georgikeranchev-del/nfc-player/PINOUT.md

# Pinout and Connection Overview

This is the single GPIO connection table for the current battery-only build.
GPIO numbers are ESP32 signal names, NOT physical header positions; clone-board
layouts vary. Classic ESP32/WROOM without PSRAM remains the working assumption,
not a verified module identity. GPIO16 must be available, not used by PSRAM.
GPIO17 is now unused; remove the previous IP5306 KEY-driver connection.
GPIO17 is the only free output-capable pin; GPIO36 is the other free input-only pin.

The symbol, GPIO and component columns are checked against
[firmware/nfc_player/pins.h](firmware/nfc_player/pins.h) and
[hardware.json](hardware.json). Update all three when deliberately changing the
pin map. Connection notes and the diagram are not an electrically checked netlist.
Component IDs correspond to [BOM.csv](BOM.csv).

<!-- PINOUT:BEGIN -->
| Symbol | GPIO | Component | Wire color | Connection and conditions |
|---|---|---|---|---|
| AMP_ENABLE | 2 | U_BUFFER | Green | SN74AHCT125N 2A, pin 5, with 10k to GND; 2Y, pin 6, goes to amplifier SD/SD_MODE. Never connect GPIO2 directly to amplifier SD. Boot-strap review required. |
| ENCODER_SW | 4 | ENC1 | Green | Encoder push switch to GND; active LOW. Wakes normal powered sleep (retaining soft song inhibition), not hard low-battery sleep or a switched-off supply. |
| PN532_SS | 5 | U_NFC | White | PN532 SS/SSEL; set the module to SPI. Verify reset-state module pulls on this boot-strap pin. |
| SD_CS | 13 | U_SD | White | SD module CS. |
| SD_SCK | 14 | U_SD | Blue | SD module SCK/CLK. |
| SD_MOSI | 15 | U_SD | Yellow | SD module MOSI/DI. Verify reset-state pulls on this boot-strap pin. |
| SD_MISO | 16 | U_SD | Brown | SD module MISO/DO; GPIO16 must not be occupied by PSRAM. |
| PN532_SCK | 18 | U_NFC | Blue | PN532 SCK. |
| PN532_MISO | 19 | U_NFC | Brown | PN532 MISO. |
| LED_DATA | 21 | U_BUFFER | White | SN74AHCT125N 1A, pin 2, with 10k to GND; 1Y, pin 3, through 330 ohm to ring DIN. |
| I2S_DOUT | 22 | U_AMP | Pink | MAX98357A DIN. |
| PN532_MOSI | 23 | U_NFC | Yellow | PN532 MOSI. |
| I2S_LRC | 25 | U_AMP | Pink | MAX98357A LRC/WS. |
| I2S_BCLK | 26 | U_AMP | Blue | MAX98357A BCLK. |
| MOTOR_GATE | 27 | U_GATE | Green | TC4420CPA INPUT pin 2 with 10k to GND; joined OUTPUT pins 6/7 through one 100 ohm resistor to IRLZ44N gate. Keep 10k directly between gate and source. GPIO27 does not drive the MOSFET gate directly. |
| ENCODER_CLK | 32 | ENC1 | Green | Encoder A/CLK; common to GND. |
| ENCODER_DT | 33 | ENC1 | Green | Encoder B/DT; common to GND. |
| BATTERY_ADC | 34 | R_BAT_TOP | Green | ADC1_CH6; 100k from SW_BAT+ to ADC node; 47k and 100nF from node to LOAD_GND. Input only; no internal pull resistors. About 1.343V at a 4.20V pack. |
| CHARGER_PRESENT | 35 | Q_VBUS | Green | 2N7000 drain with 100k pull-up to ESP32 3V3 only; LOW means IP5306 USB VBUS is present. Gate: VBUS through 10k, 100k gate-to-GND; source to LOAD_GND. Take VBUS from the IP5306 USB input, not OUT+. Input only, RTC wake capable, no internal pull. Never connect VBUS directly to a GPIO. |
| HELP_BUTTON | 39 | SW_HELP | Green | Existing momentary NO button between GPIO39 and LOAD_GND, with an external 10k pull-up to ESP32 3V3; LOW means pressed. Input only, no internal pull. A short press while idle plays /player/help.mp3. Disconnect the button from IP5306 KEY, which can sit above 3.3 V. |
<!-- PINOUT:END -->

## Signal wire color key

Use red for positive supply/VCC (including 5V) and black for GND/negative.
Use the same color for the same signal role at each component: white for CS/SS
and LED data, blue for clocks (SPI SCK and I2S BCLK), brown for MISO, yellow for
MOSI, green for control/encoder lines, and pink for I2S data and sync. For
example, both SD_MISO and PN532_MISO use brown, and both MOSI lines use yellow.
Matching color does not mean separate GPIO nets are electrically joined; follow
each symbol and GPIO in the table. Keep battery protection terminals distinct;
black denotes the negative node shown, not permission to bypass the PCM.

All ESP32-side logic is **3.3 V, not 5 V tolerant**. GPIO12 and flash GPIO6-11 are
forbidden in this design. The retained straps 2, 5 and 15 are reviewed in
[DESIGN_DECISIONS.md](DESIGN_DECISIONS.md#boot-pin-review).

## Small connection schematic

Open the full-page [SCHEMATIC.svg](SCHEMATIC.svg) for the complete module-level
view, including power protection, TPS61088, the original driver/buffer, battery ADC
and the confirmed 4 ohm / 3 W mono speaker. Named supply nets join across panels.
It is a drawing aid, not proof of clone-board internals or an ERC-checked netlist.

Battery-only whole-system wiring reference

```text
2 x VTC5A in parallel (1S2P) + fuse + 1S PCM
  PCM P+ --+------------------> IP5306 BAT+ (charger only; OUT unused)
           +-- SW_LOAD --> SW_BAT+ --> TPS61088 IN+
  PCM P- ---------------------> IP5306 BAT-, TPS61088 IN-/OUT-, LOAD_GND
  TPS61088 OUT+ (5.00 V) ------> LOAD_5V
  SW_BAT+ -- 100k --+----------> GPIO34 / ADC1_CH6
                   +-- 47k ---> LOAD_GND
                   +-- 100nF -> LOAD_GND

LOAD_5V --+--> ESP32 VIN/5V
          +--> amplifier VIN, ring 5V, AHCT125 VCC, TC4420 VDD
          +--> motor +
motor - ------> IRLZ44N drain; source --> LOAD_GND
flyback diode: anode --> motor -; band/cathode --> motor +

GPIO27 --> TC4420 pin 2; joined pins 6/7 --> 100 ohm --> IRLZ44N gate
GPIO21 --> AHCT125 channel 1 --> 330 ohm --> ring DIN
GPIO2  --> AHCT125 channel 2 -------------> amplifier SD
GPIO4  --> encoder push switch --> LOAD_GND

LOAD_GND --> module grounds, buffer/driver grounds, divider return
ESP32 3V3 --> encoder breakout VCC, only if it needs power
```

- SD and PN532 supply voltages depend on the actual breakout schematic; they are
  deliberately absent from the blanket 5 V list. Their SPI signals must be 3.3 V
  compatible. Do not drive any unpowered module through its GPIO connections.
- SN74AHCT125N DIP-14: join pins 1, 4, 7, 9, 12 to LOAD_GND; join pins 10, 13, 14
  to LOAD_5V. Outputs 8 and 11 each stay open. Never join separate outputs 3, 6,
  8 or 11 together. Inputs 2 and 5 keep separate 10k pulldowns, not direct ground
  bridges. Add 100 nF between pins 14/7. Use AHCT, not plain HC.
- TC4420CPA DIP-8: join VDD pins 1/8 to LOAD_5V; join GND pins 4/5 to LOAD_GND;
  join OUTPUT pins 6/7 before the single 100 ohm gate resistor. INPUT is pin 2;
  pin 3 is NC and stays open. All three duplicate pairs must be connected
  externally. Add 100 nF plus 1 uF local bypass across the VDD/GND groups. Gate,
  driver-input and buffer-input pulldowns remain required; this text overview
  omits their drawn symbols.
- Amplifier SD must not be hard-strapped to VIN. GAIN is separate; both speaker
  wires go to amplifier outputs, neither to ground. See the breakout checks in
  [WIRING.md](WIRING.md#dip-ahct125-led-and-amplifier).
- The load switch must remove power from BOTH the boost input and divider top.
  Do not leave a battery-powered divider driving an unpowered ESP32. Keep the
  ADC return on protected P-/LOAD_GND, never raw B-. See the
  [divider and calibration](WIRING.md#battery-voltage-divider) instructions.

DIP numbering is top view, notch at the top and pin 1 upper-left; the solder-side
view is mirrored. Use short socket-pad links or a common local rail for each
group, keeping different groups separate. See the complete
[pin-bridge tables](WIRING.md#tc4420cpa-dip-8-pin-bridges) before soldering.

The diagram is an overview, not a replacement for protection terminals, capacitor
placement and reset-state checks in [WIRING.md](WIRING.md). All load returns must
remain on the protected side of the battery circuit.

## Manufacturer reference diagrams

These are the closest useful block references, not a verified schematic of the
complete K648/DevKit/breakout combination. Use this project's GPIO assignments;
other boards' example GPIO numbers and power wiring are not interchangeable.

- [Microchip TC4420/29 datasheet, page 1](https://ww1.microchip.com/downloads/aemDocuments/documents/APID/ProductDocuments/DataSheets/21419D.pdf#page=1):
  TC4420 non-inverting DIP-8 pin diagram and the requirement to connect both pins
  of every duplicate supply/GND/output pair; pin 3 is NC.
- [TI SN74AHCT125 datasheet, page 3](https://www.ti.com/lit/ds/symlink/sn74ahct125.pdf#page=3):
  DIP-14 pin diagram; later sections cover active-LOW enables, bypass/layout and
  TTL input levels.
- [Adafruit MAX98357A mono schematic](https://cdn-learn.adafruit.com/assets/assets/000/032/642/medium800/adafruit_products_schem.png?1464034817):
  close reference for the seven-pin I2S amplifier. Compare SD/GAIN resistors and
  supply capacitors with the actual breakout; do not assume a clone matches it.
  [Downloads and board files](https://learn.adafruit.com/adafruit-max98357-i2s-class-d-mono-amp/downloads).
- [Adafruit NeoPixel wiring practices](https://learn.adafruit.com/adafruit-neopixel-uberguide/best-practices):
  data resistor, local capacitance, common ground and 3.3 V to 5 V level shifting.

The exact K648 power path, DevKit USB/VIN routing and SD/PN532 supply circuitry
still require their board schematics or inspection. They are not inferred from
the silicon names. The dedicated shunt connection diagram and scope settings are
in [MANUAL_TESTS.md](MANUAL_TESTS.md#inrush-current-with-a-shunt-and-oscilloscope).

## USB programming boundary

No tag is NOT power isolation. For the current programming procedure, disconnect
the complete player harness, including GPIOs, from ESP32 and use its USB alone.
Remove USB before reconnecting battery wiring. A powered ESP32 can back-feed
unpowered peripherals even with the motor stopped. Simultaneous charging and
fully wired dual-USB operation have separate gates in
[MANUAL_TESTS.md](MANUAL_TESTS.md#later-usb-and-charging-tests).
