georgikeranchev-del/nfc-player/MODELS.md

# 3D Model References

This page lists external mechanical references considered during development of
the NFC Vinyl Player. **This repository branch contains no 3D model files.**
The links below point to third-party pages; they are references, not included
assets, verified downloads, or confirmation that a model is used in the build.

The current mechanical concept uses an N20 geared motor, a spindle/drive
interface, a turntable, and an enclosure for the ESP32/NFC/audio electronics.
Compatibility with the actual parts has not been established for the linked
models.

## Proposed enclosure layout

The [conceptual enclosure layout](ENCLOSURE_LAYOUT.svg) places the PN532 antenna
under the platter center, keeps the battery and motor away from the antenna, and
puts the K648 charging and DevKit programming USB connectors on the same side
wall for access. It is a top-down placement suggestion, not a dimensioned model
or validated mechanical/electrical design. Verify clearances, antenna read range,
connector fit, and the USB power-isolation procedure with the actual parts before
making enclosure cutouts.

## Drive and pulleys

| Reference | Potential use | Source |
|---|---|---|
| [5mm Pulley with D-Shaft for 1/2" Spindle](https://makerworld.com/en/models/1469934-5mm-pulley-with-d-shaft-for-1-2-spindle?from=search#profileId-1534154) | Candidate pulley / spindle interface | MakerWorld |
| [N20 Motor Horn 3mm D-Shaft Flange Coupler](https://makerworld.com/en/models/1723479-n20-motor-horn-3mm-d-shaft-flange-coupler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) | Candidate motor-shaft coupling | MakerWorld |
| [polea n20](https://cults3d.com/en/3d-model/various/polea-n20) | N20 pulley reference | Cults3D |
| Worm-gear model | Drive mechanism reference | Source not recorded |

## Motor mounting and adapters

| Reference | Potential use | Source |
|---|---|---|
| [N20 Motor Bracket](https://www.printables.com/model/669433-n20-motor-bracket/related) | General N20 motor mounting | Printables |
| [N20 DC Motor Holder](https://makerworld.com/en/models/1734552-n20-dc-motor-holder#profileId-1842737) | Compact motor holder | MakerWorld |
| [N20 Reduction Gear Motor Mount](https://makerworld.com/en/models/595578-n20-geared-motor-mount?from=search#profileId-517501) | Geared-motor mounting | MakerWorld |
| [N20 Geared Motor Fixing](https://makerworld.com/en/models/1778632-n20-geared-motor-fixing?from=search#profileId-1894420) | Alternative motor mounting | MakerWorld |
| [Faller Motor Adapter N20 Geared Motor](https://makerworld.com/en/models/1907006-faller-motor-adapter-n20-geared-motor?from=search#profileId-2044507) | Motor adapter reference | MakerWorld |
| N20 bracket design files | Alternative motor bracket reference | Source page not recorded |

## Turntable and enclosure

| Reference | Potential use | Source |
|---|---|---|
| [Lazy Susan Turntable for Photo/Painting with Bearing](https://makerworld.com/en/models/1526805-lazy-susan-turntable-for-photo-painting-w-bearing#profileId-1600602) | Bearing-based turntable concept | MakerWorld |
| [Turntable — 8 cm Diameter (608 Bearing)](https://makerworld.com/en/models/756683-turntable-8cm-diameter-608-bearing#profileId-691020) | Compact platter and bearing concept | MakerWorld |
| [Digital Vinyl Record Player (NFC enabled) — V1](https://makerworld.com/en/models/140367-digital-vinyl-record-player-nfc-enabled-v1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) | Related NFC record-player concept | MakerWorld |
| [Parametric Model Maker — Universal PCB Enclosure](https://makerworld.com/en/models/2487622-universal-pcb-enclosure-fully-parametric#profileId-2733152) | Configurable electronics enclosure | MakerWorld |
| [Parametric Rounded Electronics Enclosure Box](https://www.printables.com/model/1745945-parametric-rounded-electronics-enclosure-box-usb-c/files) | Enclosure geometry reference | Printables |
| [JUUKE — RFID Music Player](https://www.printables.com/model/54266-juuke-rfid-music-player) | Related RFID player reference | Printables |

## Rights and suitability

This list does not state or imply that a linked model is free to download,
modify, or redistribute. Check the current terms on the source page for each
model before downloading, adapting, sharing, or publishing model files. A
personal-use allowance or free download does not necessarily permit public
redistribution.

Before adapting any model, verify motor dimensions, shaft geometry, bearing
dimensions, platter size, mounting holes, enclosure clearances, and fit with
the actual electronics and mechanical parts. These links are starting points,
not approved drop-in parts or a validated mechanical design.
