georgikeranchev-del/nfc-player/NFC_TAGS.md

# NFC Tags

Use each UID as the MP3 filename in the SD card's `/player` folder, followed by
`.mp3` (for example, `047D5D91E52A81.mp3`). An em dash means the tag has not
been assigned a song yet.

| Tag | UID | Artist | Track |
|---:|---|---|---|
| 1 | `047D5D91E52A81` | Mariah Carey | All I Want for Christmas Is You |
| 2 | `04955D91E52A81` | Wham! | Last Christmas |
| 3 | `04925D91E52A81` | Ariana Grande | Santa Tell Me |
| 4 | `04EA6391E52A81` | Bobby Helms | Jingle Bell Rock |
| 5 | `04E86391E52A81` | Andy Williams | It's the Most Wonderful Time of the Year |
| 6 | `04F16391E52A81` | Dean Martin | Let It Snow! Let It Snow! Let It Snow! |
| 7 | `04F26391E52A81` | Тодор Върбанов | Миг като вечност |
| 8 | `04E76391E52A81` | — | — |
| 9 | `04EB6391E52A81` | — | — |
| 10 | `04915D91E52A81` | — | — |
| 11 | `04965D91E52A81` | — | — |
| 12 | `047C5D91E52A81` | — | — |
| 13 | `04845D91E52A81` | — | — |
| 14 | `04235891E52A81` | — | — |
| 15 | `04245891E52A81` | — | — |
| 16 | `04EB5791E52A81` | — | — |
| 17 | `04F15791E52A81` | — | — |
| 18 | `04845291E52A81` | — | — |
| 19 | `04895291E52A81` | — | — |
| 20 | `045C5291E52A81` | — | — |
| 21 | `04645291E52A81` | — | — |
| 22 | `04E24B91E52A81` | — | — |
| 23 | `04E34B91E52A81` | — | — |
| 24 | `04A84B91E52A81` | — | — |
| 25 | `04AD4B91E52A81` | — | — |
| 26 | `042F4691E52A81` | — | — |
| 27 | `04354691E52A81` | — | — |
| 28 | `04E84591E52A81` | — | — |
| 29 | `04EF4591E52A81` | — | — |
| 30 | `046C3F91E52A81` | — | — |
| 31 | `046D3F91E52A81` | — | — |
| 32 | `04283F91E52A81` | — | — |
| 33 | `042F3F91E52A81` | — | — |
| 34 | `048F3991E52A81` | — | — |
| 35 | `04953991E52A81` | — | — |
| 36 | `04483991E52A81` | — | — |
| 37 | `044B3991E52A81` | — | — |
| 38 | `04AF3391E52A81` | — | — |
| 39 | `04B33391E52A81` | — | — |
| 40 | `04643391E52A81` | — | — |
| 41 | `04693391E52A81` | — | — |
| 42 | `047E2E91E52A81` | — | — |
| 43 | `04862E91E52A81` | — | — |
| 44 | `04392E91E52A81` | — | — |
| 45 | `043E2E91E52A81` | — | — |
| 46 | `04192991E52A81` | — | — |
| 47 | `041E2991E52A81` | — | — |
| 48 | `04A6B591E52A81` | — | — |
| 49 | `04B72891E52A81` | — | — |
| 50 | `04192391E52A81` | — | — |
