georgikeranchev-del/nfc-player/WIRING.md

# Battery-Only Perfboard Wiring

This is the new baseline, superseding contradictory advice in the old chat and
parent wiring file. Keep the existing classic ESP32 development board, IP5306/K648,
PN532, SD module, MAX98357A, ring, N20 motor and encoder. Reuse their existing
capacitors if identified and undamaged. The selected load supply is now a
**TPS61088 JXL V1.10 module set to 5.00 V**, replacing the XL6009. IP5306 is used
only for charging; its OUT pins do not feed the player. The battery is two matched
VTC5A cells in parallel (1S2P), with suitable 1S protection and a coordinated fuse.

Reported silicon is **ESP32-D0WD-V3, revision v3.1, with a 40 MHz crystal**.
This does not confirm the development-board/module model or PSRAM. WROOM without
PSRAM is the working assumption from the reported earlier check, not a verified
module identity. Use [PINOUT.md](PINOUT.md) for the complete GPIO table, GPIO16
restrictions and compact connection schematic. Full reported chip details are in
[README.md](README.md#detected-esp32).

## Signal wire colors

Use red for positive supply/VCC (including 5V) and black for GND/negative.
Color signal wires by role consistently across components: white for CS/SS and
LED data, blue for clocks (SPI SCK and I2S BCLK), brown for MISO, yellow for
MOSI, green for control/encoder lines, and pink for I2S data and sync. Therefore
SD and PN532 MISO use the same brown wire, and both MOSI lines use yellow. Same
color does not mean different GPIO nets are connected together; keep each routed
to its pin as shown in [PINOUT.md](PINOUT.md) and [SCHEMATIC.svg](SCHEMATIC.svg).
Keep raw cell terminals on the correct sides of the PCM; black does not authorize
bypassing battery protection or joining raw B- to system GND.

## What to buy

- **1 x SN74AHCT125N, DIP-14, plus socket:** LED level shift and amp SD isolation.
- **1 x TC4420CPA, DIP-8, plus socket:** non-inverting 5 V motor gate driver for
  the IRLZ44N you own; check the exact suffix is PDIP, not SMD/inverting TC4429.
- **1 x 1N5822 axial Schottky:** motor flyback baseline. A 1N5819 is an alternative
  only if its 1 A/transient ratings fit your measured motor. No 1N4007 for PWM.
- **100 nF X7R ceramics, >=16 V:** buy a small pack for each logic/driver supply;
  one 1 uF ceramic at the gate driver. Yellow box film caps can remain for motor
  brush suppression once their value/rating is confirmed.
- **Resistors:** keep motor 100 ohm and gate/source 10k, LED data 330 ohm. Add
  10k pulldowns at gate-driver input, amp-buffer input and LED-buffer input.
- **Battery divider:** one 100k and one 47k, both 1% metal-film, 0.25 W;
  one additional 100 nF X7R ceramic, >=16 V, at GPIO34. No KEY transistor is needed.
- **TPS61088 JXL V1.10 boost module:** verify the actual board's input range,
  output adjustment, current/thermal limits and undervoltage behavior before use.
- **Cell protection and fuse hardware:** documented protected 1S cell or compatible
  1S PCM, DC-rated fuse holder, rated battery holder/leads/connectors and heatshrink.
  Final fuse/PCM current is a measurement decision, not a generic 3 A shopping rule.
- **Perfboard, sockets/header strips, rated connectors, insulated wire, standoffs**
  and a DC-rated SPST load switch if you want physical off. Use mounting support
  for the encoder; do not support the box/knob by solder joints alone.
- Keep the existing encoder. Its push switch wakes normal powered sleep;
  cold-start uses the load switch, not IP5306 KEY.

Exact inventory and quantities are in [BOM.csv](BOM.csv). A gate driver and logic
buffer do not solve boost overload, poor wiring, inappropriate battery selection,
or a mechanically stalled platter.

## Perfboard connectors, wire and sockets

The selected ICs remain **TC4420CPA** and **SN74AHCT125N**. The previously discussed
TC4427/74HCT126 alternatives are not adopted; do not mix their pinouts or enable
wiring with this build.

Soldering module power leads directly to their labelled supply/GND pads is fine.
Terminate the other ends at rated, labelled terminal blocks on the perfboard so
modules remain removable. Secure the cable independently of the solder pad and
insulate exposed joints. Do not hang stiff wire or a heavy capacitor from a small
breakout pad. This advice is for module pads, not soldering directly to a cell.

| Proposed copper cross-section | Use and conditions |
|---|---|
| 1.5 mm2 | Ample starting point for short main power/return buses at the expected few-amp scale. It may be too stiff or large for perfboard holes; use supported distribution terminals or an insulated bus, not enlarged pads or a chain of solder blobs. |
| 0.5 mm2 | Reasonable for short individual motor, amplifier and LED power/return branches. Verify voltage drop and temperature at measured current, plus the terminal/connector rating and fuse coordination. |
| 0.33 mm2 | Electrically ample for GPIO signals; often larger than necessary. For SPI/I2S/LED data, short routing and nearby return paths matter more than copper area. |

These are conditional wiring choices, not certified current ratings. Battery-side
current can exceed 5 V load current. Include both outgoing and return conductors
when calculating voltage drop; connector contacts and thin module traces may
limit the circuit before the wire does. Keep motor/amp/ring returns separate back
to the distribution point, not through ESP32 headers or a signal-ground jumper.

Use terminal blocks specified for the conductor size and measured current. For
stranded wire under screw clamps, use suitable ferrules where the terminal maker
permits them; do not tin the clamped ends because solder can creep and loosen.
Use proper crimps/torque and provide strain relief. Soldered ends at PCB pads are
a different case and should be wetted normally. Label 5 V, 3V3, GND and signals;
different module supply voltages are not interchangeable.

Keep SPI and I2S wiring as short as practical, initially around 10 cm or less
where layout permits; this is a layout goal, not a guaranteed maximum. Route
clock/data with a nearby ground return and away from motor/gate/speaker wiring.
Route each motor or supply outgoing/return pair together. Twist the two speaker
leads together; neither speaker lead is a ground return.

Good-quality DIP-8 and DIP-14 IC sockets on perfboard are appropriate. Align the
socket notch and IC pin 1, inspect solder joints before inserting ICs, and insert
or remove only with all power disconnected. Keep the gate resistor, pulldowns
and driver bypass close to their relevant pins, not at the far end of a cable.

Headers/sockets also make the DevKit removable. If the DevKit is permanently
soldered, provide disconnectable connections for its complete player harness,
including supply and GPIO paths. The present USB programming procedure requires
that isolation; disconnecting only VIN while leaving GPIOs connected is not enough.

## Battery, protection and main switch

```text
1S2P VTC5A pack + -- F1 (near pack +) -- PCM B+
1S2P VTC5A pack - -------------------- PCM B-
PCM P+ --+---------------------------- IP5306 BAT+ (charger only)
         +-- SW_LOAD -- SW_BAT+ --+---- TPS61088 IN+
                                +---- battery divider top (100k)
PCM P- ------------------------------ IP5306 BAT-, TPS61088 IN-/OUT-, LOAD_GND

TPS61088 OUT+ (set to 5.00 V) --------- LOAD_5V star
IP5306 OUT+ and OUT-: no external load connection

LOAD_5V -> ESP32 VIN/5V, amp VIN, ring 5V, motor +, AHCT125 VCC, TC4420 VDD
LOAD_GND -> all module returns, MOSFET source, driver/buffer GND, divider return
```

Use the PCM manufacturer's real terminals, not inferred positions. A protected
cell already contains its own circuit; select one documented protection solution.
Never bypass low-side PCM protection by connecting load ground to bare cell -.
Size switch, wiring, connector and fuse for BATTERY current as well as load peaks.
Fuse coordination must allow expected transients but protect the weakest wire
and cell limits. Do not intentionally short a lithium cell to test protection.

**Move SW_LOAD from the old 5 V output position to the protected battery branch
feeding BOTH TPS61088 IN+ and the divider.** The IP5306 BAT connection stays
upstream of this switch, so charging remains possible with the player off.
Rate the switch for battery-side current, which can exceed the 5 V load current.
An output-only switch would leave the divider driving an unpowered ESP32.
Disconnect the ADC lead too whenever removing just the ESP32's power.

IP5306 BAT+/BAT- means its cell terminals (sometimes marked IN+/IN-), not its
USB 5 V input. Confirm the TPS61088 module has a common IN-/OUT- return with all
power removed. Keep both USB cables unplugged for battery-only tests. No source
mux, CC1/CC2 detection or converter EN control is implemented.

SW_LOAD open (`0`) leaves the charger connected to the protected pack; closed
(`1`) allows both the player and charger to use that port. With USB connected,
the pack can charge, remain approximately neutral or discharge depending on net
current. This is not a validated load-sharing/charge-termination circuit; test
both charge completion and net cell current with playback. IP5306 OUT is not a
charger-present signal because it can also be battery-powered.

On the schematic, only repeated instances of the SAME net label connect.
PCM P+ and SW_BAT+ are joined only through the closed switch. LOAD_GND is a
separate return net: never join positive to negative just because both are named.

For battery-only development omit the former series rail diode. Route TPS61088
output straight to the star. Do not put motor/amp current
through the ESP32 headers, skinny daisy-chain jumpers or long perfboard solder
tracks. Use short power wires and pair each signal with a nearby return path.

### Battery voltage divider

```text
SW_BAT+ (protected P+ after SW_LOAD, also TPS61088 IN+)
  |
  100k ohm, 1%, 0.25 W    R_BAT_TOP
  |
  +---------------------- GPIO34 / ADC1_CH6 (input only)
  |              |
  47k ohm        100 nF X7R
  1%, 0.25 W     >=16 V
  |              |
  +--------------+------- LOAD_GND (protected return, NEVER raw B-)
```

Fit the 47k and capacitor close to the ESP32. Keep this sense wire away from
motor/speaker/switching nodes and give it a quiet return to the ground star.
GPIO34 has no internal pull resistors; the external 47k is required. Never
connect pack voltage or regulated 5 V directly to it. Verify the divider with
a meter before attaching the ADC lead to the ESP32.

The nominal conversion is `V_ADC = V_input * 47 / 147`: 4.20 V gives about
1.343 V; 3.60 V gives 1.151 V; 3.30 V gives 1.055 V. Divider current is about
29 microamps at 4.20 V. The 100 nF capacitor filters sampling/switching noise.
Firmware uses 12-bit `analogReadMilliVolts`, 6 dB attenuation, 16 readings per
sample and a 250 ms sample interval. The measured value includes protection,
switch and wiring drop; it is the boost-input voltage, not a separate raw-cell
measurement. The ratio is not doubled for two parallel cells.

ADC background, from the ESP-IDF
[ADC](https://docs.espressif.com/projects/esp-idf/en/latest/esp32/api-reference/peripherals/adc/index.html) and
[calibration](https://docs.espressif.com/projects/esp-idf/en/latest/esp32/api-reference/peripherals/adc/adc_calibration.html)
guides: the classic ESP32 ADC reference is nominally 1100 mV but varies between
1000 and 1200 mV per chip, and the calibration driver corrects that using eFuse
values (your chip reports Vref calibration burned). Espressif also recommends a
100 nF ceramic at the ADC pin and multisampling against noise, as used here
(their graph uses 64 samples; this firmware uses 16). The Arduino
`analogReadMilliVolts` call is expected to apply that eFuse calibration, but this
is not yet verified on the actual board. The meter-derived factor below then corrects
what remains: resistor tolerance and residual ADC error. It is one point, so
also check it at a second voltage.

Calibrate `BATTERY_CALIBRATION_PERMILLE` in
[config.h](firmware/nfc_player/config.h) against a meter across SW_BAT+/LOAD_GND,
not against the nominal cell rating or a percentage estimate. The serial log
reports ADC millivolts and corrected pack millivolts at boot and every 5 s while
awake. Follow the [calibration procedure](MANUAL_TESTS.md#battery-voltage-calibration-and-cutoff)
for the correction formula, safe receive-only logging and cutoff tests.

Conservative initial settings are 3.50 V minimum for a new song and soft song
inhibition after 5 s below it. A tag request while inhibited plays
`/player/low_battery.mp3` once at volume 10 with motor/LEDs off; the warning is
limited to 10 s. Normal sleep/wake preserves this latch; rebound alone cannot
clear it. Songs re-enable only with USB present and at least 3.70 V for 30 s
(see [charger-present sense](#charger-present-sense)). A true power
cycle checks startup voltage again. Neither this threshold nor the divider can
establish that exactly 5-10% capacity remains; calibrate voltage with a meter,
then characterize the pack under the real load before choosing an SOC estimate.

Hard shutdown still occurs at startup at/below 3.30 V, after at/below 3.30 V
for 2 s while running, and immediately at/below 3.00 V on a sampled reading.
A reading above 4.35 V also stops operation as a wiring/calibration fault.
These are operating choices, not VTC5A absolute limits. Sampling is cooperative,
not a hard real-time protection circuit.

Hard low-battery shutdown stops motor/audio/NFC polling, clears LEDs and deep-sleeps
without button or timer wake. Open SW_LOAD, recharge, then switch on again;
charging alone does not wake it. **Deep sleep does not disconnect the TPS61088,
SD, PN532 or other rail loads, and the ADC no longer monitors during sleep.**
Do not store it in this state. Keep the PCM as independent protection. A proper
hardware low-voltage disconnect is needed for unattended automatic isolation;
do not assume the JXL board's UVLO or EN provides that without its schematic and
measurements. A heatsink or quieter audio cannot correct over-discharge.

### Charger-present sense

```text
IP5306 USB-C VBUS pad --10k-- +-- 2N7000 gate (G)
                              |
                              100k to LOAD_GND

ESP32 3V3 --100k-- +-- 2N7000 drain (D) -- GPIO35 (input only)
2N7000 source (S) -- LOAD_GND
```

Take VBUS from the IP5306 module's USB input (connector VBUS pin or input pad),
not OUT+, which can also be battery-powered. That module's ground is the protected
P-/LOAD_GND. USB present puts about 4.5 V on the gate and GPIO35 reads LOW. This
only senses USB power: it does not switch any load, and it does not prove the
cell is actually charging. The pull-up goes to ESP32 3V3 only, never 5 V. TO-92
2N7000 pin order varies by maker; check the datasheet or the flat face. GPIO35 is
input only with no internal pull and supports deep-sleep wake; GPIO17 does not.

### Fuse and PCM during startup

**A 3 A marking is not an instantaneous cutoff at 3.001 A.** The BOM still leaves
fuse and protection selection open; no particular 3 A part is approved here.

- An ordinary cartridge/blade fuse is a one-time protective component. A short
  pulse above its rating may survive, while a larger/longer overload can melt it.
  Use the exact fuse's time-current curve, pulse endurance, ambient derating and
  DC breaking rating. Fast-acting and time-delay 3 A fuses need not behave alike.
  If it blows, correct the cause before replacing it with the approved type; do
  not bridge it or simply install a higher rating.
- A resettable PTC is different: it heats into a high-resistance state and may
  recover after the fault is removed and it cools. Hold/trip current, resistance
  and delay differ from a fuse. It is not an automatic drop-in substitute here.
- A PCM normally turns off its protection MOSFETs on a detected fault rather than
  consuming itself. Its advertised continuous rating, overcurrent trip threshold,
  detection delay and permitted surge rating are separate specifications. A
  "3 A" board may trip above 3 A, but that does not authorize sustained overload.
  Recovery may require load removal or a manufacturer-specified charger event;
  never short pads to reset it. A poorly rated, overheated or miswired board can
  still be permanently damaged, including failure to protect.

Coordinate the fuse, PCM, cell and weakest wire/contact with the measured battery
current and surge duration. The motor ramp does not control all cold-start inrush:
charging the capacitors and booting the boost happen before the ramp. If normal
running already exceeds a PCM's continuous rating, a longer ramp cannot fix it.
Repeated trips, hot protection parts or blown fuses are faults to investigate,
not expected startup behavior. Keep the load off until the cause is understood.

### Connecting the 18650 holder and PCM

The diagram above applies to a **documented 1S, 4.20 V Li-ion, common-port PCM**:
the same protected P+/P- port carries discharge and later charge current. It is
not a pin-position guide for an unidentified board. The PCM protects the pack;
IP5306 charges it and TPS61088 supplies the player. A 2S/3S PCM is not suitable.

For the matched parallel pack, the electrical connections are:

```text
Pack + --> F1 close to pack + --> PCM B+
Pack - ------------------------> PCM B-
PCM P+ ------------------------> IP5306 BAT+ and SW_LOAD input
PCM P- ------------------------> IP5306 BAT- and protected system return
```

All player grounds stay on the protected side. Do not connect holder - directly
to ESP32, amplifier, motor-driver or USB ground around the PCM. Some common-port
boards share B+ and P+ copper; others label pads differently. Do not infer pad
positions or add bridges from that generalization. Boards with separate C-/P-
charge/discharge ports require their own wiring plan; the K648 BAT connection
both charges and discharges, so do not join those ports by guesswork.

Remove the cell from the holder and disconnect every USB/external supply before
soldering or continuity work. Mount the PCM on insulated supports or secure it
against an insulating backing; no underside copper may touch perfboard buses,
fasteners or the cell holder. Solder flexible pigtails to its labelled pads and
land them on rated terminals, with strain relief. Do not force stiff 1.5 mm2 wire
onto tiny PCM pads or carry pack current through small perfboard pad chains.
Do not solder directly to the cell. Leave the fuse/cell out until wiring checks
are complete, and follow the board maker's connection/activation sequence.

The holder must fit the actual cell and have documented contacts/leads adequate
for battery current. A holder is not protection. If using an already protected
cell or protected pack, use its documented terminals instead of blindly stacking
a second, uncoordinated PCM. The exact PCM model/pad labels and fuse part number
are needed before treating the wiring and surge tolerance as verified.

### 18650 selection

The selected cells are **two matched VTC5A cells in parallel**, not in series.
"18650" describes size, not chemistry, current capability or protection. The
general checks below still apply to this 1S2P pack and the actual K648 charger.

| Parameter | What to look for |
|---|---|
| Chemistry/voltage | Conventional rechargeable Li-ion, nominal 3.6/3.7 V, charged to 4.20 V. Verify K648 is configured for that cell. LiFePO4 or a different charge-voltage chemistry is not a drop-in substitute. |
| Capacity | Genuine 2500-3500 mAh is a practical shopping range; around 3000 mAh is a useful starting point. Capacity mainly determines runtime, not whether motor startup succeeds. |
| Discharge rating | Prefer a documented continuous discharge rating of at least 10 A as a shopping target with margin; ignore unqualified "pulse/max" marketing. Final suitability depends on measured current, sag and temperature. This is not a 10 A fuse recommendation or an IP5306 output rating. |
| Charge rating | Check the cell's recommended and maximum charge current separately from its discharge rating. The actual K648 cell-charging current must comply; USB input current is not the same measurement. If incompatible, reconfigure only by the module's documented method or select a compatible cell before charging. |
| Protection | Use a documented protected cell/pack OR a suitable external 1S PCM. Its charge/discharge limits, trip thresholds and wiring must suit the cell and measured startup current. A high-current bare cell behind a low-current protection board is still limited by that board. |
| Construction | Buy from a reputable battery supplier with a manufacturer datasheet and traceable model. Reject damaged wraps/positive-terminal insulators, dents and unknown salvaged cells. Avoid implausible capacity claims. |
| Fit/connections | Protected/button-top cells may be longer than a bare 65 mm cell. Check the exact holder dimensions and contact-current rating. Use a rated holder or professionally assembled pack with welded tabs/leads; do not solder directly to the cell. |
| Temperature/voltage limits | Follow the cell datasheet's operating and charging temperatures and minimum voltage. Choose an operating cutoff with sag margin above the minimum/protection trip. Supervise development charging; do not assume the module has cell-temperature sensing. |

A higher-current cell does not force current into the load, but it can deliver
more current into a fault: protection, a correctly coordinated fuse and insulated
connections remain necessary. It cannot increase the TPS61088 module's own output
capability. A healthy existing cell that meets the measured requirements need
not be replaced just to obtain a larger mAh number.

Size the battery path from battery current, not the 5 V current. Approximately:

$$
I_{cell} \approx \frac{V_{load} I_{load}}{V_{cell} \eta}
$$

For example, a 5.1 V load drawing 2 A needs about **3.75 A from a 3.2 V cell** at
an assumed 85% boost efficiency, before allowing for transients. These are sizing
examples, not measured load/efficiency or a recommended discharge endpoint. Check
startup at the lowest intended battery level: the same output power needs more
battery current as voltage falls.

For a first runtime estimate:

$$
t_{hours} \approx \frac{V_{nominal} C_{Ah} \eta}{P_{load,average}}
$$

A 3.6 V, 3000 mAh cell contains nominally 10.8 Wh. At an assumed 85% efficiency,
that gives roughly **1.8 hours at 5.1 V / 1 A average load**, or **0.9 hours at
2 A**. Usable capacity, cutoff, motor/audio peaks, temperature and cell condition
can reduce this. Measure average power with representative music and lighting;
do not treat the full labelled capacity as mAh available at 5 V.

### Selected VTC5A 1S2P pack

The two matched VTC5A cells have the same voltage as one cell: about **3.6 V
nominal and 4.20 V fully charged**, not 7.2/8.4 V. Capacity adds and current is
shared, subject to cell/connection matching. Actual runtime depends on usable capacity, cutoff,
temperature and conversion efficiency. Charging from the same limited current
will take roughly longer in proportion to capacity.

The electrical topology is parallel (positive to positive, negative to negative),
but this is not authorization to connect two loose cells or holders together.
Different cell voltages can cause large equalization current before the player
draws anything. A pack PCM does not necessarily interrupt circulating current
between parallel cells. Matching voltage alone also does not prove cell health.

For this build, prefer a professionally assembled **protected 1S2P pack** from a
reputable supplier, with matched chemistry/model/capacity/age/state of charge,
appropriate pack/inter-cell fault protection and documented output/charge ratings.
Use the protected output for the charger and switched player branch:

```text
Protected 1S2P pack + --> coordinated fuse --> IP5306 BAT+ and SW_LOAD input
Protected 1S2P pack - ----------------------> IP5306 BAT- and LOAD_GND
```

Fuse placement/rating must follow the pack design; its internal protected cells
are not exposed in this connection drawing. Do not charge the cells independently
then reconnect them at different charge levels, hot-swap a cell, or use a two-cell
series holder. **Never feed a 2S pack (up to 8.4 V) into this 1S battery input.**

A parallel pack may reduce battery sag, but a 3 A pack PCM/fuse does not become a
6 A device: it still carries the combined pack current. The converter's output
limit also stays unchanged. Verify charging compatibility, pack construction,
protection and mechanical clearance; a parallel pack is not a boost-overload fix.

## Motor: driven gate, low-side switching

```text
GPIO27 -- TC4420 INPUT (pin 2)
             |
           10k
             |
            GND

TC4420 pins 1 + 8 (VDD) -> LOAD_5V; pins 4 + 5 (GND) -> LOAD_GND
100 nF + 1 uF between TC4420 VDD and GND, close to pins
TC4420 OUTPUT pins 6 + 7 -- one 100 ohm -- IRLZ44N GATE
IRLZ44N GATE -- 10k ------- IRLZ44N SOURCE -> LOAD_GND
IRLZ44N DRAIN ------------ MOTOR -
LOAD_5V ----------------- MOTOR +

Flyback diode: ANODE -> drain/motor -; CATHODE (band) -> motor +/LOAD_5V
100 nF across motor terminals (brush suppression)
220 uF (>=10 V): + -> LOAD_5V; - -> LOAD_GND, NOT drain/motor -
```

### TC4420CPA DIP-8 pin bridges

This table and the AHCT125 table below use **top-view numbering**: markings facing
you, notch at the top, pin 1 upper-left, numbering counterclockwise. The solder-side
view is mirrored. Disconnect battery and USB and remove the ICs before soldering
socket links.

| Pin(s) | Connection |
|---|---|
| 1 + 8 | Join VDD pins; connect to LOAD_5V. |
| 4 + 5 | Join GND pins; connect to LOAD_GND. |
| 6 + 7 | Join OUTPUT pins; through one 100 ohm resistor to IRLZ44N gate. |
| 2 | INPUT from GPIO27, with a 10k resistor to LOAD_GND. |
| 3 | NC; leave unconnected. |

**All three duplicate pairs must be connected externally**, including both VDD
pins, as required by the
[Microchip datasheet, page 1](https://ww1.microchip.com/downloads/aemDocuments/documents/APID/ProductDocuments/DataSheets/21419D.pdf#page=1).
These are three separate groups; never bridge supply, ground and output together.
Use short wire links between perfboard/socket pads, or a short common rail for
each group, not large solder blobs. Do not bridge intervening pins. Keep the
100 nF and 1 uF bypass capacitors in parallel between the joined VDD pins 1/8 and
GND pins 4/5, close to the driver.

TC4420 accepts TTL-style input at a 5 V supply; its minimum supply is 4.5 V.
Gate/input pulldowns are mandatory even with brownout enabled. Check on-state
drain voltage and temperature under the actual belt load. Protect against exposed
MOSFET tab contact: the IRLZ44N tab is electrically connected to drain.

### Practical perfboard placement and solder order

Use this as a placement guide, not a scale drawing. Keep the TC4420 socket and
its small-signal input on the control side; put the MOSFET and motor/power
terminals near the board edge. Leave a little working room around the socket for
the three pin-bridge groups and bypass capacitors.

```text
COMPONENT SIDE — notch upward; pin numbers are top-view

                        TC4420 socket, notch up
                       ┌──────────────────────┐
 LOAD_5V --------------│ 1 VDD         VDD 8 │-------------- LOAD_5V
 GPIO27 ---------------│ 2 IN           OUT 7│--+
                       │ 3 NC           OUT 6│--+--100 ohm--MOSFET GATE
 LOAD_GND -------------│ 4 GND         GND 5 │-------------- LOAD_GND
                       └──────────────────────┘
 GPIO27 / pin-2 node -- 10k -- LOAD_GND
 100 nF + 1 uF across the LOAD_5V and LOAD_GND groups, near the socket

 MOTOR / POWER EDGE:
 LOAD_5V -> MOTOR +       MOSFET SOURCE -> LOAD_GND
 MOTOR - -> MOSFET DRAIN  10k from MOSFET GATE to SOURCE
 diode across motor terminals, band toward MOTOR +
```

The socket's solder-side view is mirrored. Follow the numbered socket pads and
verify the notch orientation before soldering; do not copy the component-side
positions by eye while looking at the underside.

Recommended order:

1. With battery and USB disconnected, mark the socket notch and place the socket,
   motor MOSFET, and terminal blocks. Make sure the MOSFET tab cannot touch other
   metal or exposed conductors.
2. Solder and inspect the socket links for pins 1/8 (VDD), 4/5 (GND), and 6/7
   (OUTPUT) as separate groups. Keep pin 3 unconnected. Check the pin-bridge
   table above against the exact TC4420 package datasheet.
3. Add the 100 nF and 1 uF bypass capacitors close to the socket, each across the
   VDD and GND groups. Keep the leads short; neither capacitor goes in series.
4. Wire GPIO27 to pin 2 and fit its 10k pulldown from that input node to
   LOAD_GND. Fit the single 100 ohm resistor between joined output pins 6/7 and
   the MOSFET gate. Put the other 10k directly between the MOSFET gate and source.
5. Connect MOSFET source to the LOAD_GND power return and drain to MOTOR -;
   connect MOTOR + to LOAD_5V. Place the flyback diode across the motor terminals
   (band toward MOTOR +). Put the 220 uF capacitor across LOAD_5V and LOAD_GND
   near the motor supply branch, not from drain to ground. The separate 100 nF
   brush-suppression capacitor goes across the motor terminals.
6. Keep the motor's LOAD_5V and LOAD_GND current path short and adequately rated.
   Route it directly to the power distribution/terminal points, not through the
   TC4420 socket, GPIO connector, or a long chain of thin perfboard pads. Keep
   GPIO27/input wiring away from the motor and gate wiring; route motor leads
   together.
7. Before inserting the IC or applying power, inspect for solder bridges and use
   a meter to check that LOAD_5V is not shorted to LOAD_GND. Verify diode
   orientation, MOSFET G/D/S orientation, resistor values, and continuity of
   each pin group against the drawing. Then continue with the staged checks in
   [MANUAL_TESTS.md](MANUAL_TESTS.md#perfboard-assembly-and-acceptance).

## DIP AHCT125: LED and amplifier

Pin numbers below are for SN74AHCT125N DIP-14, top-view numbering verified against
the [TI datasheet, page 3](https://www.ti.com/lit/ds/symlink/sn74ahct125.pdf#page=3):

| Connection | Pin(s) |
|---|---|
| VCC -> LOAD_5V, GND -> LOAD_GND | 14, 7 |
| Channel 1 /OE -> GND | 1 |
| GPIO21 -> 1A, 10k from 1A to GND | 2 |
| 1Y -> 330 ohm -> LED DIN | 3 |
| Channel 2 /OE -> GND | 4 |
| GPIO2 -> 2A, 10k from 2A to GND | 5 |
| 2Y -> amplifier SD/SD_MODE | 6 |
| Unused /3OE and /4OE -> VCC | 10, 13 |
| Unused 3A and 4A -> GND; outputs unconnected | 9, 12; outputs 8, 11 |

For this two-channel build, the socket bridge groups are:

- **1, 4, 7, 9, 12 -> LOAD_GND.**
- **10, 13, 14 -> LOAD_5V.**

Keep these two groups separate. Short links to the same local rail count as
connections; separate pin-to-pin jumpers are not needed when the rail already
joins the pins. Inputs 2 and 5 retain their separate 10k pulldowns, not direct
ground bridges. **Never join separate channel outputs 3, 6, 8 or 11 together.**
Unused outputs 8 and 11 are each left open, not bridged to each other or a rail.

Add 100 nF at pins 14/7. AHCT accepts 3.3 V HIGH when supplied at 5 V; plain HC
does not offer the same guarantee. Keep LED data short. Tie all grounds together.
Do not power the ESP32 alone while its GPIOs drive an unpowered AHCT/module.

**Rewire GPIO2:** it now goes to AHCT input, NOT directly to amp SD. This prevents
an amp-board 5 V pull-up from reaching a non-5-V-tolerant ESP32 boot pin. Verify
the SD pin is not hard-strapped to VIN; a hard strap must be resolved from the
board schematic before driving it LOW. A normal weak pull-up can be overridden
by the buffer. Do not blindly remove a GAIN or SD resistor.

MAX98357A BCLK=GPIO26, LRC=GPIO25, DIN=GPIO22. GAIN is independent of SD; leaving
it open gives nominal 9 dB only if the breakout does not override it. SD HIGH
selects a channel as well as enabling output. Check mono/stereo content. Speaker
goes between amplifier + and - outputs; NEITHER speaker lead connects to ground.

The speaker is confirmed as **mono, 4 ohm, 3 W**, a suitable nominal load for the
MAX98357A. The 3 W marking is a power-handling rating, not a constant electrical
load. Start at low volume and avoid sustained clipping/full-scale test tones;
the amplifier can approach or exceed that nominal power under some conditions.
Its wattage label is not a speaker-protection limiter. Neither speaker lead goes
to GND, including an oscilloscope ground clip.

## Encoder and removal of KEY control

```text
Encoder SW -> GPIO4; other switch terminal -> GND
Encoder A/CLK -> GPIO32; B/DT -> GPIO33; common -> GND
Encoder breakout VCC -> 3V3 only, if the module needs it
```

Disconnect the old GPIO17-to-KEY transistor circuit (at least its 1k base resistor);
GPIO17 is now unused and is the only free output-capable pin.
Firmware no longer configures that pin, creates a KEY timer or issues taps.
Do not join KEY to GPIO4. The charger's onboard button may remain, but it does
not control the TPS61088 path or wake an unpowered player. Normal sleep wakes
with the encoder; low-battery lockout requires recharge and a power cycle.

### Help button

```text
ESP32 3V3 --10k-- +-- GPIO39 (input only)
                  |
existing NO button --- LOAD_GND
```

Reuse the existing momentary button, but move it from the IP5306 KEY pad: one
lead to GPIO39 and the other to LOAD_GND, with a 10k pull-up to ESP32 3V3.
IP5306 KEY can sit above 3.3 V, so it must never share a node with the GPIO.
GPIO39 has no internal pull-up, so the resistor is required. GPIO36 is the other
free input-only pin. A spare 100 nF ceramic from GPIO39 to GND is optional;
Espressif documents glitches on GPIO36/39 in some ADC and sleep cases, and the
40 ms software debounce covers them. This button cannot wake deep sleep.

If the transistor circuit stays on GPIO17 as it was, do not enable that pin as
an input with a pull-up: the 1k and 10k would hold the base partly on.

## SD, PN532 and decoupling

Use [PINOUT.md](PINOUT.md). PN532 must be set to SPI. Confirm each breakout's allowed
power voltage and 3.3 V logic levels; a module labelled 5V may have an onboard
regulator, while a bare SD/PN532 device cannot simply take 5 V. Supply these
modules only according to their own schematic, not from the general 5 V list.

| Location | Existing/additional capacitance |
|---|---|
| TPS61088 output | Existing 1000 uF + 100 nF only after checking JXL startup/inrush and allowed capacitance |
| Battery ADC node | 100 nF to LOAD_GND, close to GPIO34; not a 5 V supply bypass |
| ESP32 VIN | Existing board capacitors + local 100 nF; extra 470 uF only as a measured trial |
| MAX98357A VIN | 100 uF + 100 nF |
| LED ring | 470 uF + 100 nF |
| Motor rail | 220 uF to GND, 100 nF across motor brushes |
| AHCT125 | 100 nF ceramic |
| TC4420 | 100 nF + 1 uF ceramic |

Electrolytics on 5 V: >=10 V rating, correct polarity. Yellow plastic box caps
are often film; read markings rather than assume. Short-leaded ceramics belong
at logic/driver supply pins. Large bulk caps cannot cover seconds-long shutdown
and can worsen inrush. Do not keep increasing them without waveforms.

### Capacitor placement on module pins

Yes: a capacitor directly across a module's correct supply and GND pads is useful
when it keeps the leads short. Put the 100 nF ceramic closest to the supply entry
or IC supply pins; place bulk electrolytics nearby and mechanically support them.
On socketed ICs, the bypass can be soldered to the perfboard/socket supply pads
on the underside, clear of adjacent pins and insulated against accidental contact.
For AHCT125, it goes between pins 14 and 7. For TC4420CPA, put both the 100 nF
and 1 uF ceramics across joined VDD pins 1/8 and joined GND pins 4/5. The capacitors
connect between these groups; do not directly short the supply and ground groups.

Do not put capacitors in series with a supply, across arbitrary signal pins, or
between either amplifier speaker output and GND. The motor's small brush capacitor
is the deliberate exception across motor terminals; its bulk capacitor remains
between the motor's supply and GND, not across the switching drain. Check existing
module capacitors before adding more bulk. Every added bulk capacitor also adds
startup charging current, so record the fitted values in the manual test results.

## Perfboard assembly and acceptance

Follow the staged assembly/acceptance checklist in
[MANUAL_TESTS.md](MANUAL_TESTS.md#perfboard-assembly-and-acceptance). That guide
also owns the battery-only test matrix, motor-ramp comparison, measurement log
fields and later charging/dual-USB gates. Those procedures are not recorded
hardware passes or authorization to connect unverified supplies.

## Platter tuning

Keep the existing N20. Start with near-equal pulleys around 20 mm effective belt
diameter so an 8 mm spindle bore has adequate wall material. About 50 mm shaft
spacing with a slotted motor mount is a reasonable layout trial, not a speed
setting. Keep the platter balanced, not arbitrarily heavy. Use a smooth 8 mm
bearing seat and don't clamp the 608ZZ's two races together.

Measure and adjust speed using
[MANUAL_TESTS.md](MANUAL_TESTS.md#platter-speed-check).
