georgikeranchev-del/nfc-player/HELP_GUIDE.txt

Добре дошли при вашия мини грамофон.

Поставете мини плоча върху основата, за да чуете съответната песен. Всяка
плоча може да възпроизведе песента до три пъти. Махнете плочата, за да спрете
възпроизвеждането, или поставете друга, за да смените песента.

Използвайте въртящото се копче, за да регулирате звука. Натиснете го, за да събудите
грамофона. За да го приспите, натиснете и задръжте копчето за около секунда и половина, след което го отпуснете.

Когато не звучи песен, натиснете червения бутон за помощ, за да чуете това
упътване. Натиснете го отново, за да спрете възпроизвеждането.

Използвайте USB-C порта, за да заредите батерията.

Ако чуете предупреждение за изтощена батерия, включете подходящо зарядно.

Малкото копче служи за пълно изключване на грамофончето, за да се пести батерията.

Зареждането е винаги възможно, без значение от състоянието на бутоните и дали в момента звучи песен.

Приятно слушане!
