georgikeranchev-del/nfc-player/firmware/nfc_player/encoder.h

#pragma once
#include "interfaces.h"

class EncoderInput : public IEncoder {
public:
  void begin() override;
  bool pressed() const override;
  bool helpPressed() const override;
  int8_t delta(uint32_t now) override;
private:
  int lastClock_ = 1;
  uint32_t lastTurn_ = 0;
};
