georgikeranchev-del/nfc-player/firmware/nfc_player/player.cpp

#include "player.h"
#include <stdio.h>
#include <string.h>

void Player::begin(uint32_t now) {
  bootAt_ = lastActivity_ = buttonChanged_ = now;
  bool powerReady = Power.begin();
  bool batteryUnsafe = Power.batteryMillivolts() <= Config::BATTERY_LOW_MV ||
      (Power.batteryMillivolts() > Config::BATTERY_MAX_VALID_MV && !Power.chargerPresent());
  // The switched 5 V rail stays off until the pack is known to be safe, so unsafe starts load nothing.
  if (powerReady && !batteryUnsafe) Power.enablePeripherals();
  Encoder.begin();
  buttonRaw_ = buttonStable_ = Encoder.pressed();
  buttonArmed_ = !buttonRaw_;
  helpRaw_ = helpStable_ = Encoder.helpPressed();
  helpChanged_ = now;
  Leds.begin();
  Leds.mode(LedMode::Off, now);
  if (!powerReady) { fail("Power monitoring initialization failed", now); return; }
  if (!Motor.begin()) { fail("Motor PWM initialization failed", now); return; }
  if (batteryUnsafe) {
    sleepForBattery(now);
    return;
  }
  if (Power.batteryMillivolts() < Config::BATTERY_START_MIN_MV) Power.inhibitPlayback(true);
  state_ = PlayerState::BootSD;
}

void Player::stopTrack(uint32_t now, LedMode mode) {
  Motor.stop();
  Audio.stop();
  Leds.mode(mode, now);
}

void Player::fail(const char *message, uint32_t now) {
  error_ = message;
  stopTrack(now, LedMode::Off);
  Nfc.stop();
  state_ = PlayerState::Fault;
}

void Player::requestSleep(uint32_t now) {
  stopTrack(now, LedMode::Off);
  Nfc.stop();
  state_ = PlayerState::WaitRelease;
}

void Player::sleep(bool allowButtonWake, bool allowChargerWake) {
  state_ = PlayerState::Sleeping;
  Power.sleep(allowButtonWake, allowChargerWake);
}

bool Player::batteryLow(uint32_t now) {
  uint32_t voltage = Power.batteryMillivolts();
  if (voltage <= Config::BATTERY_CRITICAL_MV) return true;
  // Over-range is a divider-fault sentinel; charging legitimately elevates the reading, so trust the PCM then.
  if (voltage > Config::BATTERY_MAX_VALID_MV && !Power.chargerPresent()) return true;
  if (voltage > Config::BATTERY_LOW_MV) { lowBatteryPending_ = false; return false; }
  if (!lowBatteryPending_) { lowBatteryPending_ = true; lowBatteryAt_ = now; }
  return now - lowBatteryAt_ >= Config::BATTERY_LOW_HOLD_MS;
}

void Player::sleepForBattery(uint32_t now) {
  error_ = "Battery voltage unsafe; check divider or recharge and power-cycle";
  Power.inhibitPlayback(true);
  requestSleep(now);
  sleep(false, true);
}

void Player::checkRecovery(uint32_t now) {
  if (!Power.playbackInhibited() || !Power.chargerPresent() ||
      Power.batteryMillivolts() < Config::BATTERY_RECOVER_MV) {
    recoverPending_ = false;
    return;
  }
  if (!recoverPending_) { recoverPending_ = true; recoverAt_ = now; }
  if (now - recoverAt_ < Config::BATTERY_RECOVER_HOLD_MS) return;
  recoverPending_ = false;
  Power.inhibitPlayback(false);
  error_ = "";
  if (state_ == PlayerState::Idle) Leds.mode(LedMode::Standby, now);
}

void Player::checkPlaybackBattery(uint32_t now) {
  if (Power.playbackInhibited()) return;
  if (Power.batteryMillivolts() >= Config::BATTERY_START_MIN_MV) {
    softBatteryPending_ = false;
    return;
  }
  if (!softBatteryPending_) { softBatteryPending_ = true; softBatteryAt_ = now; }
  if (now - softBatteryAt_ < Config::BATTERY_SOFT_HOLD_MS) return;
  Power.inhibitPlayback(true);
  softBatteryPending_ = false;
  error_ = "Low battery; songs inhibited";
  if (state_ == PlayerState::MotorRamp || state_ == PlayerState::Playing || state_ == PlayerState::Help) {
    stopTrack(now, LedMode::Off);
    state_ = PlayerState::Idle;
    lastActivity_ = now;
  } else if (state_ == PlayerState::Idle) {
    Leds.mode(LedMode::Off, now);
  }
}

void Player::playBatteryWarning(uint32_t now) {
  state_ = PlayerState::Idle;
  lastActivity_ = now;
  error_ = "Low battery; songs inhibited";
  snprintf(path_, sizeof(path_), "%s/%s", Config::TRACK_DIRECTORY, Config::LOW_BATTERY_FILE);
  if (!Storage.exists(path_)) { error_ = "Low battery; warning MP3 missing"; return; }
  if (!Audio.play(path_, Config::LOW_BATTERY_VOLUME)) {
    Audio.stop();
    error_ = "Low battery; warning MP3 failed";
    return;
  }
  warningAt_ = now;
  state_ = PlayerState::BatteryWarning;
}

void Player::button(uint32_t now) {
  bool pressed = Encoder.pressed();
  if (pressed != buttonRaw_) { buttonRaw_ = pressed; buttonChanged_ = now; }
  if (pressed) lastActivity_ = now;
  if (now - buttonChanged_ < Config::BUTTON_DEBOUNCE_MS) return;
  if (!buttonArmed_) {
    if (!pressed) { buttonArmed_ = true; buttonStable_ = false; }
    return;
  }
  if (buttonStable_ != pressed) {
    buttonStable_ = pressed;
    if (pressed) pressedAt_ = now;
    else if (state_ == PlayerState::WaitRelease) { sleep(); return; }
  }
  if (buttonStable_ && state_ != PlayerState::WaitRelease &&
      now - pressedAt_ >= Config::BUTTON_HOLD_MS) requestSleep(now);
}

void Player::helpButton(uint32_t now) {
  bool pressed = Encoder.helpPressed();
  if (pressed != helpRaw_) { helpRaw_ = pressed; helpChanged_ = now; }
  if (now - helpChanged_ < Config::BUTTON_DEBOUNCE_MS || helpStable_ == pressed) return;
  helpStable_ = pressed;
  if (pressed) requestHelp(now);
}

void Player::requestHelp(uint32_t now) {
  lastActivity_ = now;
  if (state_ == PlayerState::Help) {
    stopTrack(now, Power.playbackInhibited() ? LedMode::Off : LedMode::Standby);
    state_ = PlayerState::Idle;
    return;
  }
  if (state_ != PlayerState::Idle) return;
  if (Power.playbackInhibited() || Power.batteryMillivolts() < Config::BATTERY_START_MIN_MV) {
    Power.inhibitPlayback(true);
    playBatteryWarning(now);
    return;
  }
  char help[Config::TRACK_PATH_CAPACITY];
  snprintf(help, sizeof(help), "%s/%s", Config::TRACK_DIRECTORY, Config::HELP_FILE);
  if (!Storage.exists(help)) { error_ = "Help MP3 missing"; return; }
  if (!Audio.play(help, volume_)) { Audio.stop(); error_ = "Help MP3 failed"; return; }
  helpAt_ = now;
  state_ = PlayerState::Help;
}

void Player::startTrack(uint32_t now, bool userRequest) {
  stopTrack(now, LedMode::Off);
  if (Power.playbackInhibited() || Power.batteryMillivolts() < Config::BATTERY_START_MIN_MV) {
    Power.inhibitPlayback(true);
    if (userRequest) playBatteryWarning(now);
    else {
      error_ = "Low battery; songs inhibited";
      state_ = PlayerState::Idle;
      lastActivity_ = now;
    }
    return;
  }
  if (!Storage.exists(path_)) {
    error_ = "Track not found; remove and re-present tag after fixing SD";
    state_ = PlayerState::Idle;
    Leds.mode(LedMode::Standby, now);
    return;
  }
  Motor.start(now);
  lastActivity_ = now;
  state_ = PlayerState::MotorRamp;
}

void Player::tick(uint32_t now) {
  if (state_ == PlayerState::Sleeping) return;
  Power.tick(now);
  if (batteryLow(now)) { sleepForBattery(now); return; }
  if (state_ == PlayerState::Fault) return;
  checkPlaybackBattery(now);
  checkRecovery(now);
  button(now);
  if (state_ == PlayerState::WaitRelease || state_ == PlayerState::Sleeping) return;
  helpButton(now);
  int8_t delta = Encoder.delta(now);
  if (delta != 0) {
    int target = static_cast<int>(volume_) + delta;
    if (target < Config::MIN_VOLUME) target = Config::MIN_VOLUME;
    if (target > Config::MAX_VOLUME) target = Config::MAX_VOLUME;
    volume_ = static_cast<uint8_t>(target);
    if (state_ != PlayerState::BatteryWarning) Audio.volume(volume_);
    lastActivity_ = now;
  }

  uint32_t elapsed = now - bootAt_;
  switch (state_) {
    case PlayerState::BootSD:
      if (elapsed >= Config::BOOT_SD_EARLIEST_MS) {
        if (!Storage.begin()) { fail("SD initialization failed", now); return; }
        state_ = PlayerState::BootNfc;
      }
      return;
    case PlayerState::BootNfc:
      if (elapsed >= Config::BOOT_NFC_EARLIEST_MS) {
        if (!Nfc.begin()) { fail("PN532 initialization failed", now); return; }
        state_ = PlayerState::BootReady;
      }
      return;
    case PlayerState::BootReady:
      if (elapsed >= Config::BOOT_READY_EARLIEST_MS) {
        if (!Audio.begin()) { fail("Audio initialization failed", now); return; }
        Leds.mode(Power.playbackInhibited() ? LedMode::Off : LedMode::Standby, now);
        state_ = PlayerState::Idle;
        lastActivity_ = now;
      }
      return;
    default: break;
  }

  TagState tag;
  if (Nfc.poll(tag)) {
    tag.uid[sizeof(tag.uid) - 1] = '\0';
    lastActivity_ = now;
    if (strcmp(uid_, tag.uid) != 0) {
      memcpy(uid_, tag.uid, sizeof(uid_));
      error_ = "";
      if (uid_[0] == '\0') {
        if (state_ != PlayerState::BatteryWarning && state_ != PlayerState::Help) {
          stopTrack(now, Power.playbackInhibited() ? LedMode::Off : LedMode::Stopping);
          state_ = PlayerState::Idle;
        }
      } else {
        snprintf(path_, sizeof(path_), "%s/%s.mp3", Config::TRACK_DIRECTORY, uid_);
        plays_ = 0;
        Leds.selectPattern();
        startTrack(now, true);
      }
    }
  }

  if (state_ == PlayerState::MotorRamp) {
    lastActivity_ = now;
    Motor.tick(now);
    if (Motor.ready()) {
      if (!Audio.play(path_, volume_)) {
        stopTrack(now, LedMode::Standby);
        error_ = "MP3 start failed; remove and re-present tag to retry";
        state_ = PlayerState::Idle;
      } else {
        Leds.mode(LedMode::Starting, now);
        state_ = PlayerState::Playing;
      }
    }
  } else if (state_ == PlayerState::Playing) {
    lastActivity_ = now;
    if (!Audio.tick(now)) {
      if (++plays_ < Config::MAX_PLAYS) startTrack(now, false);
      else { stopTrack(now, LedMode::Standby); state_ = PlayerState::Idle; }
    }
  } else if (state_ == PlayerState::Help) {
    lastActivity_ = now;
    if (now - helpAt_ >= Config::HELP_MAX_MS || !Audio.tick(now)) {
      stopTrack(now, Power.playbackInhibited() ? LedMode::Off : LedMode::Standby);
      state_ = PlayerState::Idle;
    }
  } else if (state_ == PlayerState::BatteryWarning) {
    lastActivity_ = now;
    if (now - warningAt_ >= Config::LOW_BATTERY_MAX_MS || !Audio.tick(now)) {
      stopTrack(now, LedMode::Off);
      state_ = PlayerState::Idle;
    }
  }
  Leds.tick(now);
  if (state_ == PlayerState::Idle && !buttonRaw_ && !buttonStable_ &&
      now - lastActivity_ >= Config::IDLE_SLEEP_MS) {
    requestSleep(now);
    sleep();
  }
}
