georgikeranchev-del/nfc-player/firmware/nfc_player/player.h

#pragma once
#include "interfaces.h"

enum class PlayerState { BootSD, BootNfc, BootReady, Idle, MotorRamp, Playing, BatteryWarning, Help, WaitRelease, Sleeping, Fault };

class Player {
public:
  Player(IPower &power, IMotor &motor, ILeds &leds, IAudio &audio,
         INfc &nfc, IStorage &storage, IEncoder &encoder)
    : Power(power), Motor(motor), Leds(leds), Audio(audio), Nfc(nfc), Storage(storage), Encoder(encoder) {}
  void begin(uint32_t now);
  void tick(uint32_t now);
  PlayerState state() const { return state_; }
  const char *error() const { return error_; }
  uint8_t volume() const { return volume_; }
  uint8_t completedPlays() const { return plays_; }
private:
  void button(uint32_t now);
  void helpButton(uint32_t now);
  void requestHelp(uint32_t now);
  void requestSleep(uint32_t now);
  void sleep(bool allowButtonWake = true, bool allowChargerWake = false);
  bool batteryLow(uint32_t now);
  void sleepForBattery(uint32_t now);
  void checkPlaybackBattery(uint32_t now);
  void checkRecovery(uint32_t now);
  void playBatteryWarning(uint32_t now);
  void stopTrack(uint32_t now, LedMode mode);
  void startTrack(uint32_t now, bool userRequest);
  void fail(const char *message, uint32_t now);
  IPower &Power;
  IMotor &Motor;
  ILeds &Leds;
  IAudio &Audio;
  INfc &Nfc;
  IStorage &Storage;
  IEncoder &Encoder;
  PlayerState state_ = PlayerState::BootSD;
  const char *error_ = "";
  uint32_t bootAt_ = 0, lastActivity_ = 0, buttonChanged_ = 0, pressedAt_ = 0;
  uint32_t lowBatteryAt_ = 0;
  uint32_t softBatteryAt_ = 0, warningAt_ = 0, recoverAt_ = 0, helpAt_ = 0, helpChanged_ = 0;
  bool buttonRaw_ = false, buttonStable_ = false, buttonArmed_ = true;
  bool lowBatteryPending_ = false;
  bool softBatteryPending_ = false, recoverPending_ = false;
  bool helpRaw_ = false, helpStable_ = false;
  uint8_t volume_ = Config::INITIAL_VOLUME, plays_ = 0;
  char uid_[Config::UID_CAPACITY] = {};
  char path_[Config::TRACK_PATH_CAPACITY] = {};
};
