georgikeranchev-del/nfc-player/firmware/nfc_player/power.h

#pragma once
#include "interfaces.h"

class PowerControl : public IPower {
public:
  bool begin() override;
  void enablePeripherals() override;
  void tick(uint32_t now) override;
  uint32_t batteryMillivolts() const override { return batteryMillivolts_; }
  bool playbackInhibited() const override;
  void inhibitPlayback(bool inhibited) override;
  bool chargerPresent() const override { return chargerPresent_; }
  void sleep(bool allowButtonWake, bool allowChargerWake) override;
  static constexpr uint32_t batteryMillivoltsFromAdc(uint32_t adcMillivolts,
      uint32_t calibrationPermille = Config::BATTERY_CALIBRATION_PERMILLE) {
    return static_cast<uint32_t>((static_cast<uint64_t>(adcMillivolts) *
      (Config::BATTERY_DIVIDER_TOP_OHMS + Config::BATTERY_DIVIDER_BOTTOM_OHMS) *
      calibrationPermille + static_cast<uint64_t>(Config::BATTERY_DIVIDER_BOTTOM_OHMS) * 500) /
      (static_cast<uint64_t>(Config::BATTERY_DIVIDER_BOTTOM_OHMS) * 1000));
  }
private:
  void sampleInputs();
  void logBattery() const;
  uint32_t sampledAt_ = 0, loggedAt_ = 0;
  uint32_t adcMillivolts_ = 0, batteryMillivolts_ = 0;
  bool chargerPresent_ = false;
};
