georgikeranchev-del/nfc-player/(commit log)

2026-09-15 оптимизация от гемини
2026-09-15 най доброто към момента от chat gpt
2026-09-15 бягаща лед светлина
2026-09-15 new led patterns with better syntax
2026-09-24 all led patterns
2026-09-27 soft start motor and less led brightness
    New wiring.md updates
    .gitignore updates
2026-09-28 new design approach
    [BOM.csv]
2026-09-28 pinout.md and manual tests added
    [BOM.csv]
2026-10-01 New visual schematic. More details listed
    [BOM.csv]
2026-10-20 Schematic attempt
2026-10-20 Soldering guiding ideas
2026-11-02 Low battery soft stop
2026-11-02 Introduce help button and charge sense path
2026-11-11 5V separation with pmosfet
